chuong-nm/KiCad_LIB_project/3dmodels/degson-dg103-series-5-0mm-terminal-block-pack-1/STEP/DG103-5.0-xxP (pitch 5.0mm)/DG103.JPG

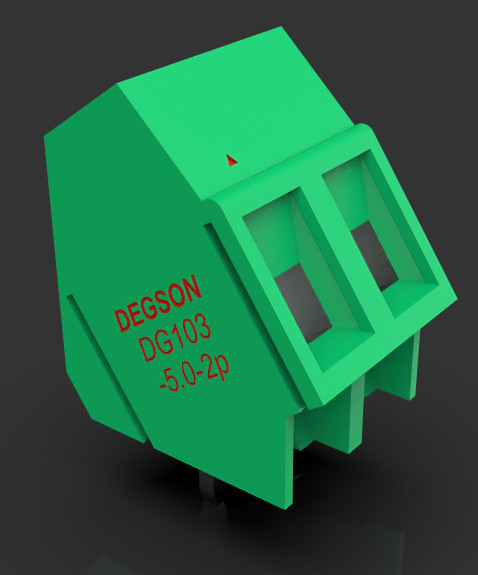
3dmodels/degson-dg103-series-5-0mm-terminal-block-pack-1/STEP/DG103-5.0-xxP (pitch 5.0mm)/DG103.JPG
