chuong-nm/KiCad_LIB_project/3dmodels/jst-gh-1-25mm-connector-set-1/JST Assortment - 1.25.PNG

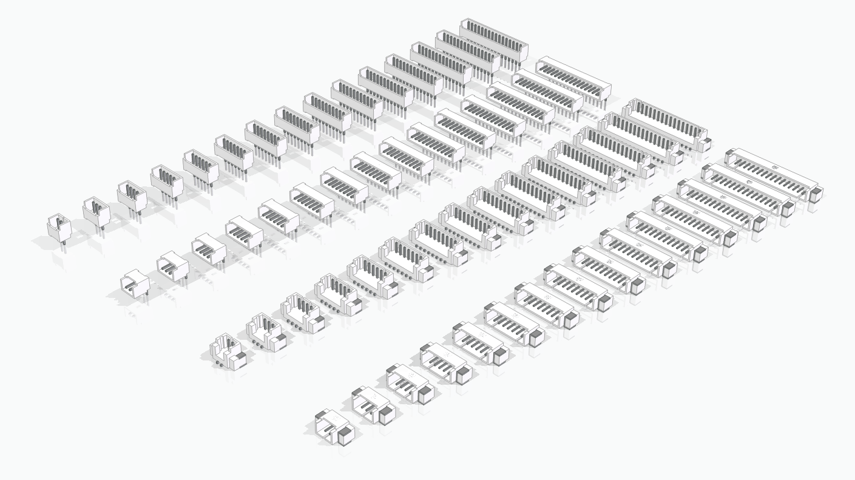
3dmodels/jst-gh-1-25mm-connector-set-1/JST Assortment - 1.25.PNG
