chuong-nm/KiCad_LIB_project/3dmodels/terminal-block-7-62mm-assortment/Terminal Block - 7.62mm - Assortment.PNG

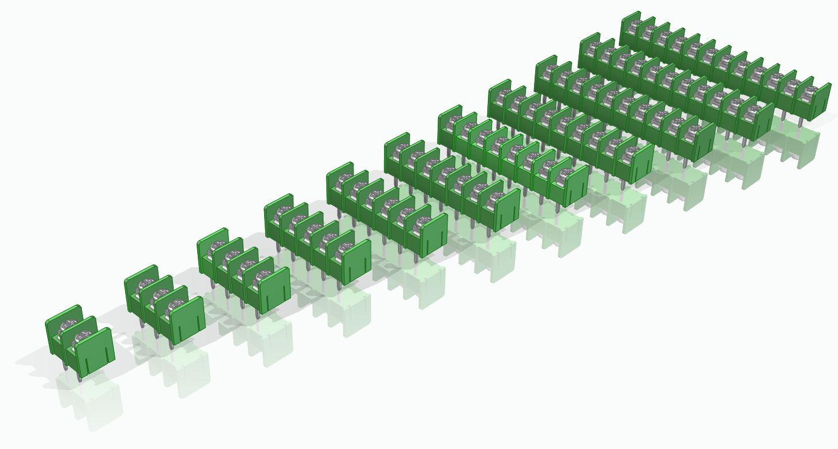
3dmodels/terminal-block-7-62mm-assortment/Terminal Block - 7.62mm - Assortment.PNG
