chuong-nm/KiCad_LIB_project/3dmodels/Converter_DCDC/OKI-78SR_Horizontal.FCStd

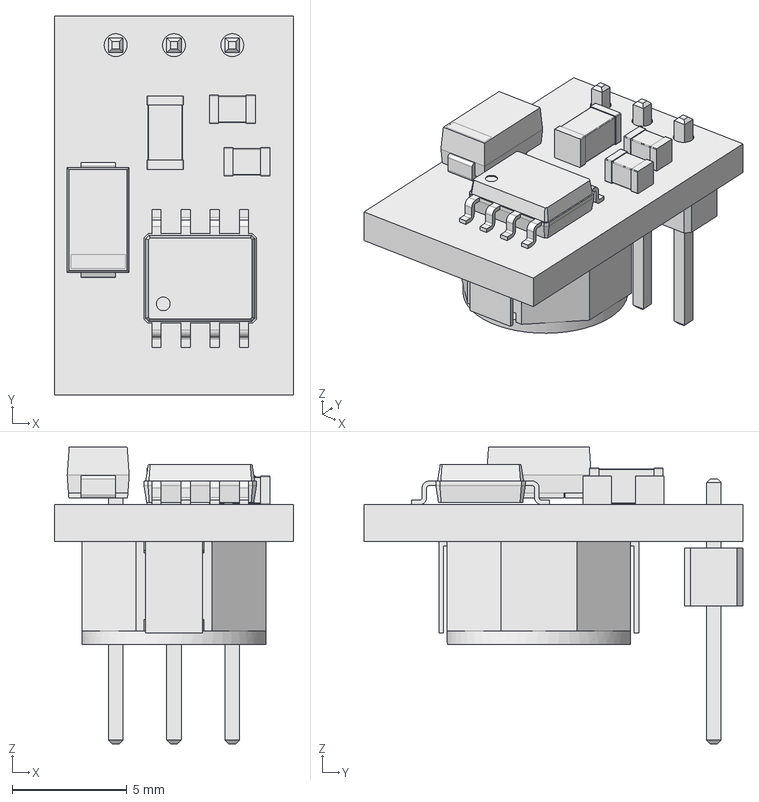
[picture p6: CAD file, 2022-12-01]
3dmodels/Converter_DCDC/OKI-78SR_Horizontal.FCStd
10.4 x 16.5 x 12.9 mm
