chuong-nm/KiCad_LIB_project/3dmodels/jst-gh-1-25mm-connector-set-1/JST - GH - SMD - Right - 1.25mm/JST - GH - SMD (R) - 5Pin - 1.25mm.stp

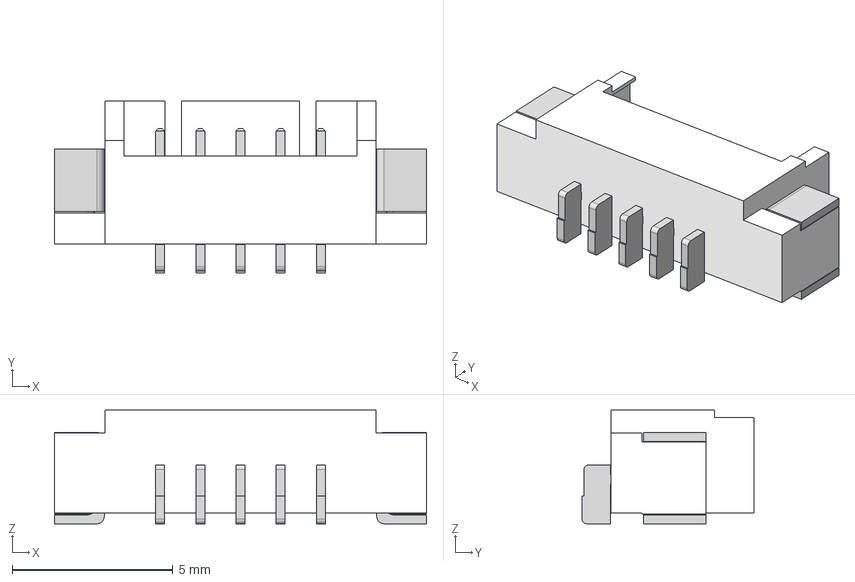
[picture p8: CAD file, 2022-12-01]
3dmodels/jst-gh-1-25mm-connector-set-1/JST - GH - SMD - Right - 1.25mm/JST - GH - SMD (R) - 5Pin - 1.25mm.stp
11.6 x 5.35 x 3.53 mm
