chuong-nm/KiCad_LIB_project/3dmodels/jst-gh-1-25mm-connector-set-1/JST - GH - Thru - Right - 1.25mm/JST - GH - Thru (R) - 14Pin - 1.25mm.stp

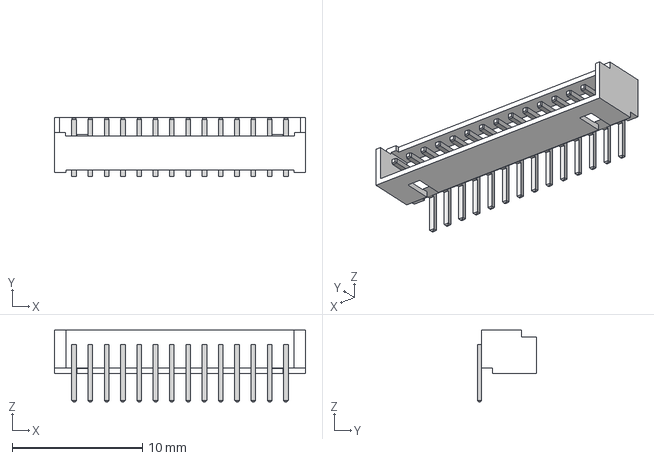
[picture p10: CAD file, 2022-12-01]
3dmodels/jst-gh-1-25mm-connector-set-1/JST - GH - Thru - Right - 1.25mm/JST - GH - Thru (R) - 14Pin - 1.25mm.stp
19.2 x 4.50 x 5.49 mm
