chuong-nm/KiCad_LIB_project/3dmodels/jst-gh-1-25mm-connector-set-1/JST - GH - Thru - Vertical - 1.25mm/JST - GH - Thru (V) - 14Pin - 1.25mm.stp

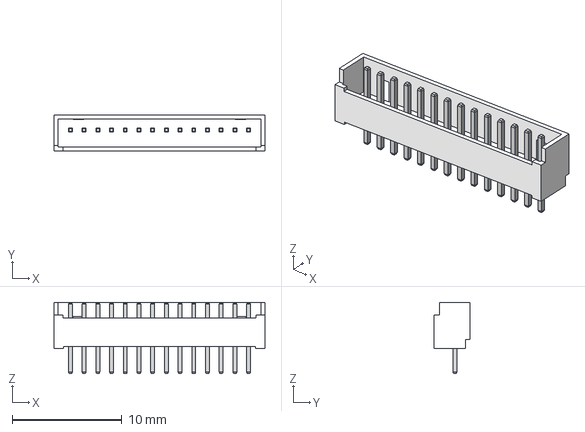
[picture p11: CAD file, 2022-12-01]
3dmodels/jst-gh-1-25mm-connector-set-1/JST - GH - Thru - Vertical - 1.25mm/JST - GH - Thru (V) - 14Pin - 1.25mm.stp
19.2 x 3.33 x 6.48 mm
