chuong-nm/KiCad_LIB_project/3dmodels/jst-sh-smd-connectors-1/SHR-xxV-S/SHR-14V-S.STEP

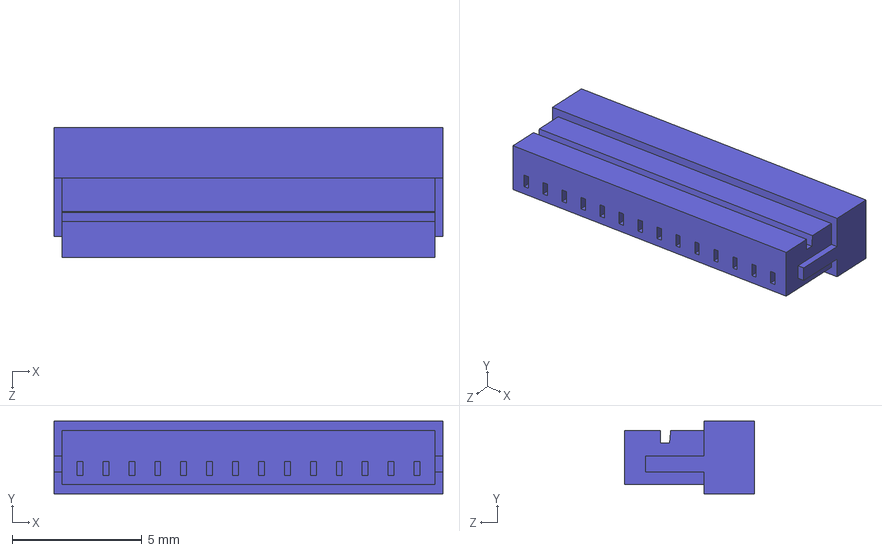
[picture p14: CAD file, 2022-12-01]
3dmodels/jst-sh-smd-connectors-1/SHR-xxV-S/SHR-14V-S.STEP
15.0 x 2.80 x 5.00 mm
