chuong-nm/KiCad_LIB_project/3dmodels/jst-sh-smd-connectors-1/SSH-003T-P0.2-H/SSH-003T-P0.2-H.STEP

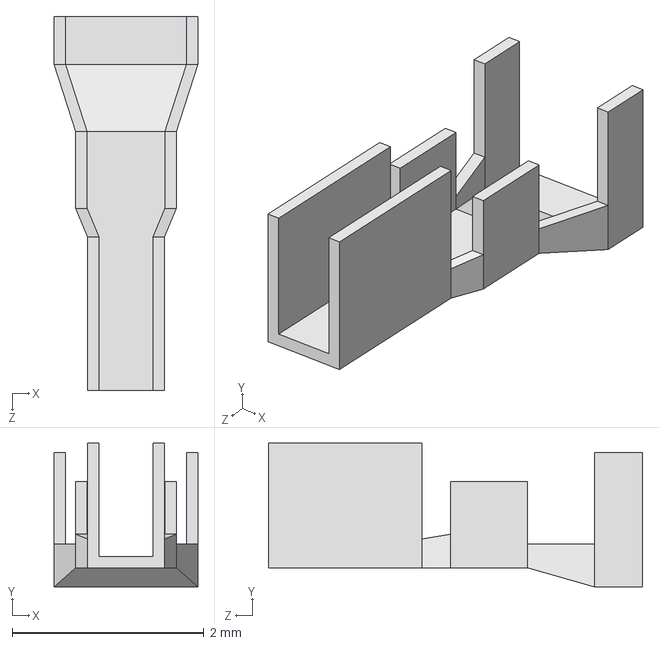
[picture p16: CAD file, 2022-12-01]
3dmodels/jst-sh-smd-connectors-1/SSH-003T-P0.2-H/SSH-003T-P0.2-H.STEP
1.50 x 1.50 x 3.90 mm
