chuong-nm/KiCad_LIB_project/3dmodels/Potentiometer_SMD.sdshapes/Potentiometer_Bourns_3314J_Vertical.FCStd

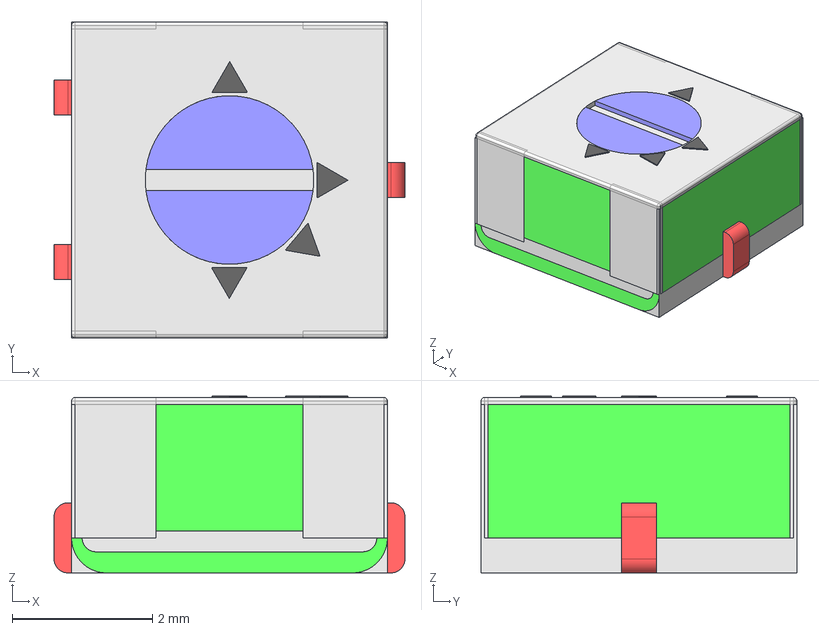
[picture p17: CAD file, 2022-12-01]
3dmodels/Potentiometer_SMD.sdshapes/Potentiometer_Bourns_3314J_Vertical.FCStd
5.00 x 4.50 x 2.52 mm
