chuong-nm/KiCad_LIB_project/3dmodels/SIM7600E.step

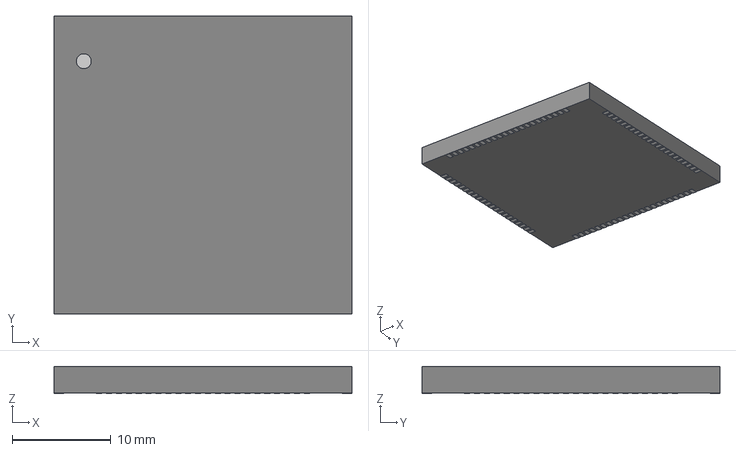
[picture p18: CAD file, 2023-04-05]
3dmodels/SIM7600E.step
30.1 x 30.1 x 2.75 mm
