chuong-nm/KiCad_LIB_project/3dmodels/terminal-block-7-62mm-assortment/Terminal Block - 7.62mm - 7 Pin.stp

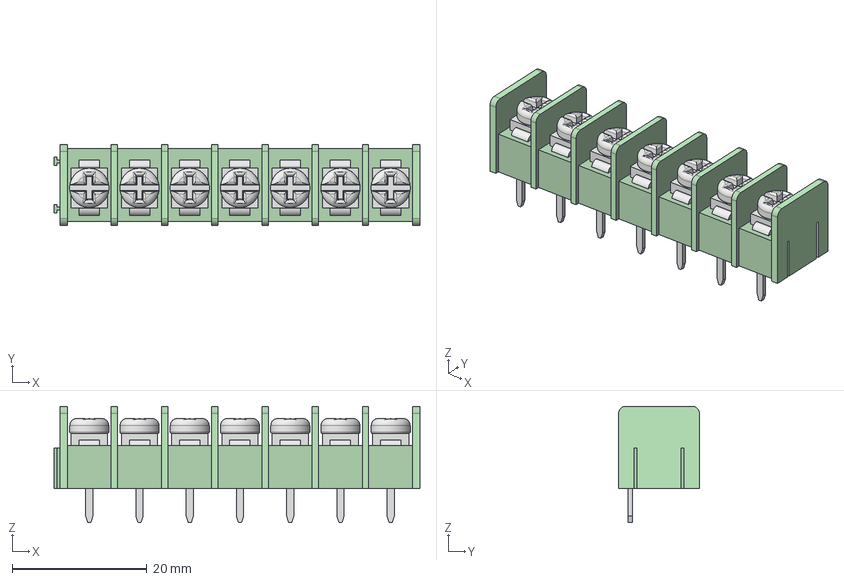
[picture p19: CAD file, 2022-12-01]
3dmodels/terminal-block-7-62mm-assortment/Terminal Block - 7.62mm - 7 Pin.stp
54.4 x 12.0 x 17.3 mm
