chuong-nm/KiCad_LIB_project/3dmodels/TerminalBlock_HB9500/HB9500_01x10_P9.50mm.step

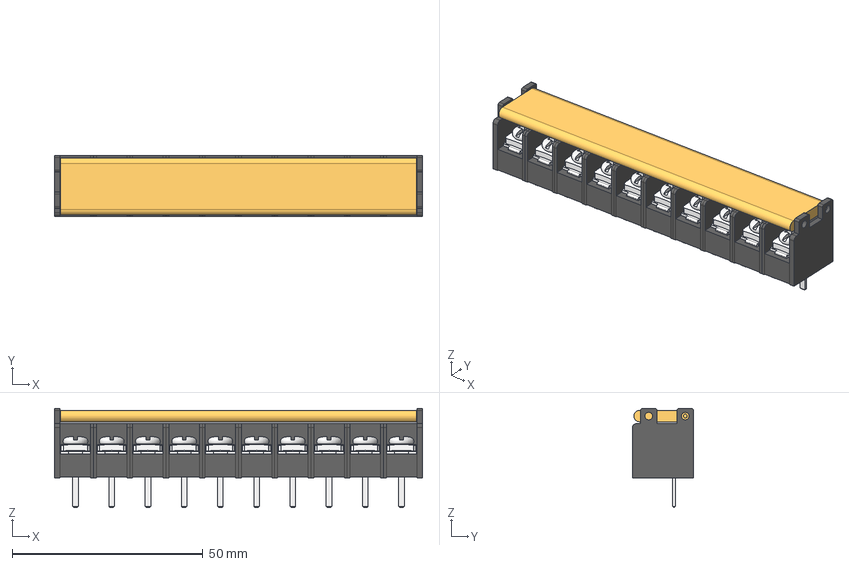
[picture p20: CAD file, 2022-12-01]
3dmodels/TerminalBlock_HB9500/HB9500_01x10_P9.50mm.step
96.5 x 16.0 x 26.0 mm
BodyLeft
BodyRight
Cover
LCS_Origin x 8
BodyCenter x 8
LCS_BodyCenter x 8
