chuong-nm/KiCad_LIB_project/3dmodels/Converter_DCDC/OKI-78SR_Vertical.FCStd

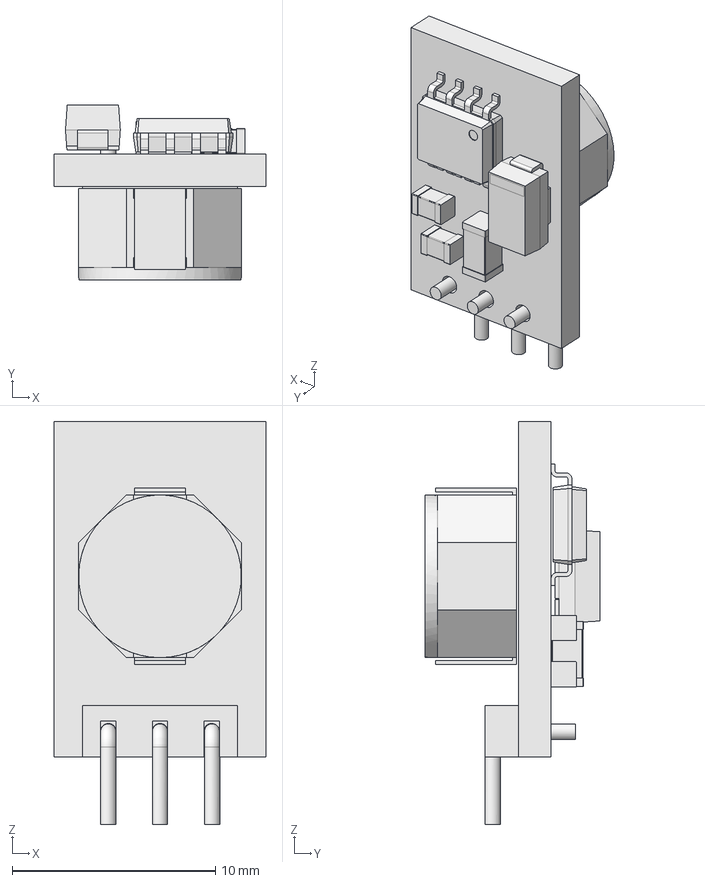
[picture p21: CAD file, 2022-12-01]
3dmodels/Converter_DCDC/OKI-78SR_Vertical.FCStd
10.4 x 8.60 x 19.8 mm
