chuong-nm/KiCad_LIB_project/3dmodels/LY68L6400SLIT.stp

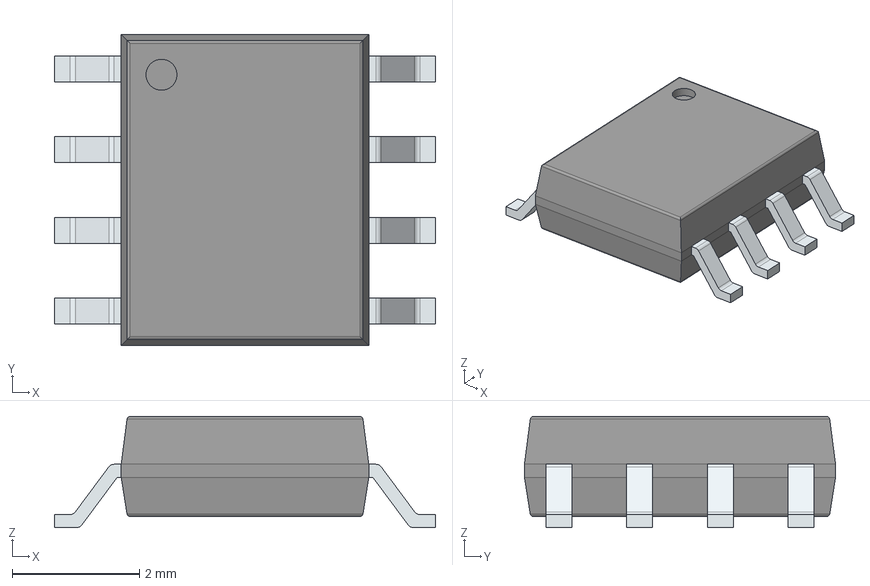
[picture p31: CAD file, 2022-12-01]
3dmodels/LY68L6400SLIT.stp
6.00 x 4.90 x 1.75 mm
PinsArrayLR
