chuong-nm/KiCad_LIB_project/3dmodels/terminal-block-7-62mm-assortment/Terminal Block - 7.62mm - 6 Pin.stp

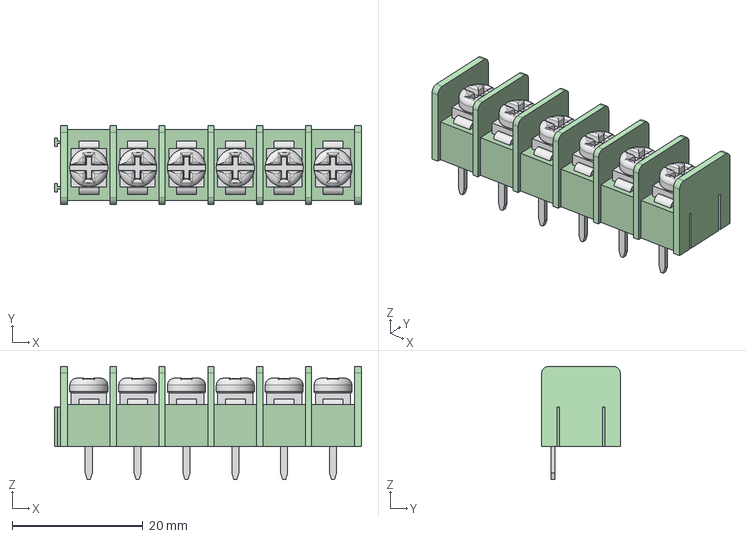
[picture p32: CAD file, 2022-12-01]
3dmodels/terminal-block-7-62mm-assortment/Terminal Block - 7.62mm - 6 Pin.stp
46.9 x 12.0 x 17.3 mm
