chuong-nm/KiCad_LIB_project/3dmodels/jst-sh-smd-connectors-1/SHR-xxV-S/SHR-09V-S.STEP

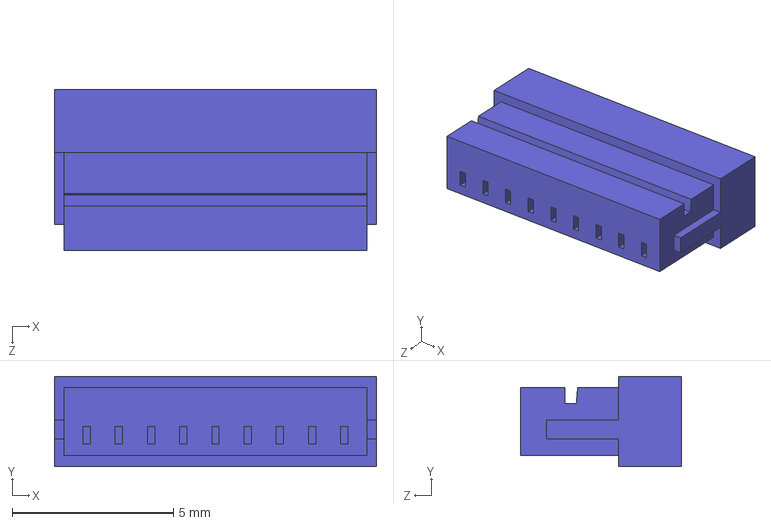
[picture p41: CAD file, 2022-12-01]
3dmodels/jst-sh-smd-connectors-1/SHR-xxV-S/SHR-09V-S.STEP
10.0 x 2.80 x 5.00 mm
