chuong-nm/KiCad_LIB_project/3dmodels/PCF8563TS_5,118.stp

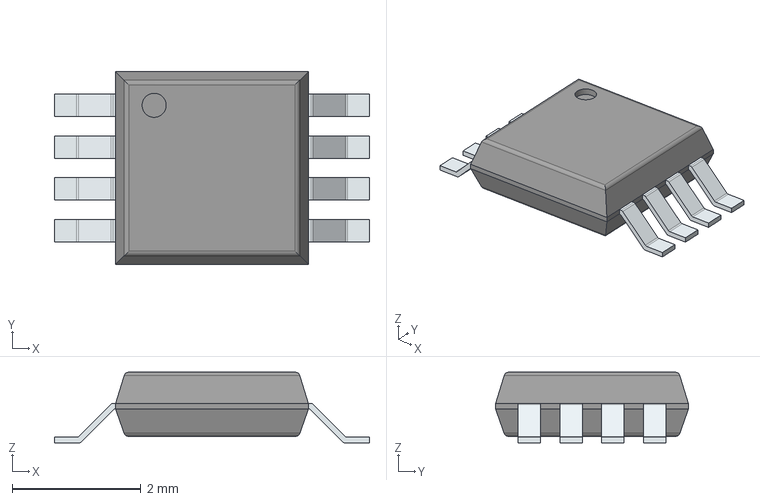
[picture p43: CAD file, 2022-12-01]
3dmodels/PCF8563TS_5,118.stp
4.90 x 3.00 x 1.10 mm
PinsArrayLR
