chuong-nm/KiCad_LIB_project/3dmodels/degson-dg103-series-5-0mm-terminal-block-pack-1/STEP/DG103-5.0-xxP (pitch 5.0mm)/DG103-5.0-02P-14-00AH.STEP

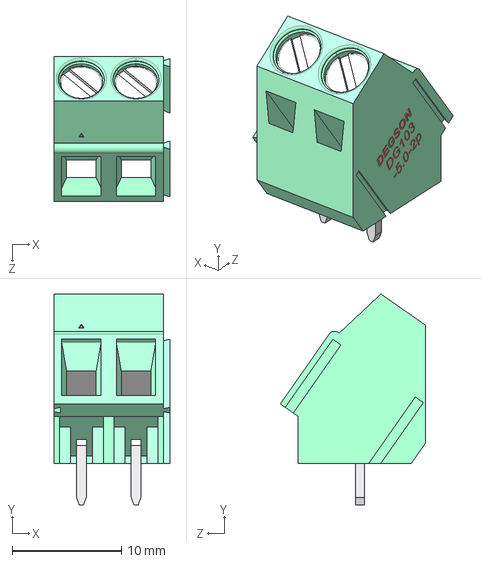
[picture p46: CAD file, 2022-12-01]
3dmodels/degson-dg103-series-5-0mm-terminal-block-pack-1/STEP/DG103-5.0-xxP (pitch 5.0mm)/DG103-5.0-02P-14-00AH.STEP
10.6 x 19.3 x 13.3 mm
