chuong-nm/KiCad_LIB_project/3dmodels/jst-gh-1-25mm-connector-set-1/JST - GH - Thru - Right - 1.25mm/JST - GH - Thru (R) - 6Pin - 1.25mm.stp

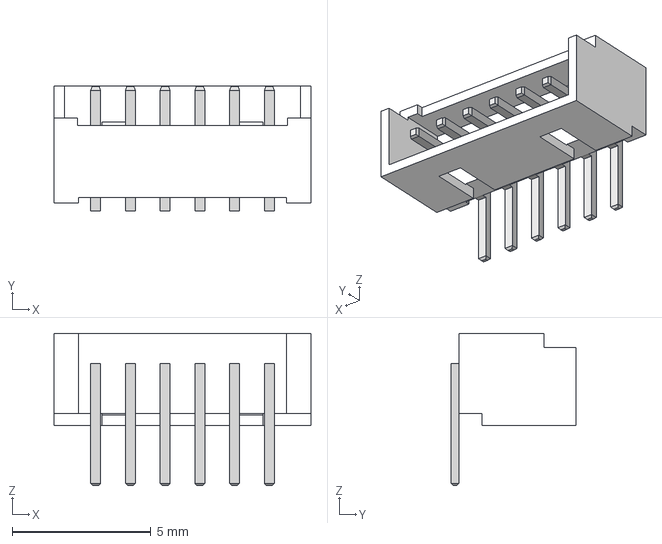
[picture p49: CAD file, 2022-12-01]
3dmodels/jst-gh-1-25mm-connector-set-1/JST - GH - Thru - Right - 1.25mm/JST - GH - Thru (R) - 6Pin - 1.25mm.stp
9.25 x 4.50 x 5.49 mm
