chuong-nm/KiCad_LIB_project/3dmodels/jst-sh-smd-connectors-1/BMxxB-SRSR-TB/BM10B-SRSS-TB.STEP

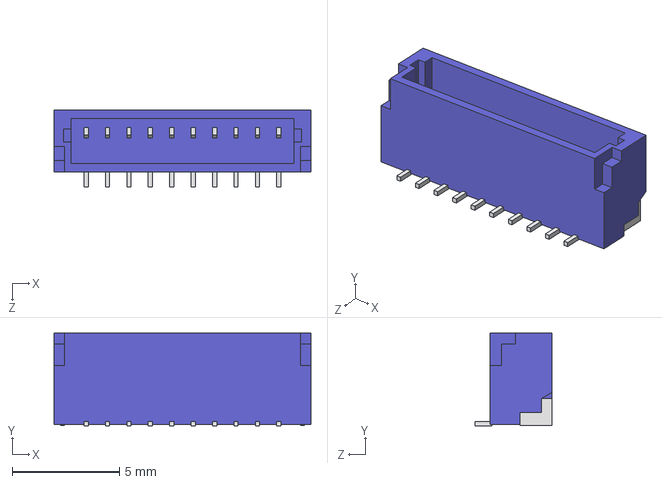
[picture p51: CAD file, 2022-12-01]
3dmodels/jst-sh-smd-connectors-1/BMxxB-SRSR-TB/BM10B-SRSS-TB.STEP
12.0 x 4.32 x 3.60 mm
