chuong-nm/KiCad_LIB_project/3dmodels/jst-sh-smd-connectors-1/SHR-xxV-S-B/SHR-04V-S-B.STEP

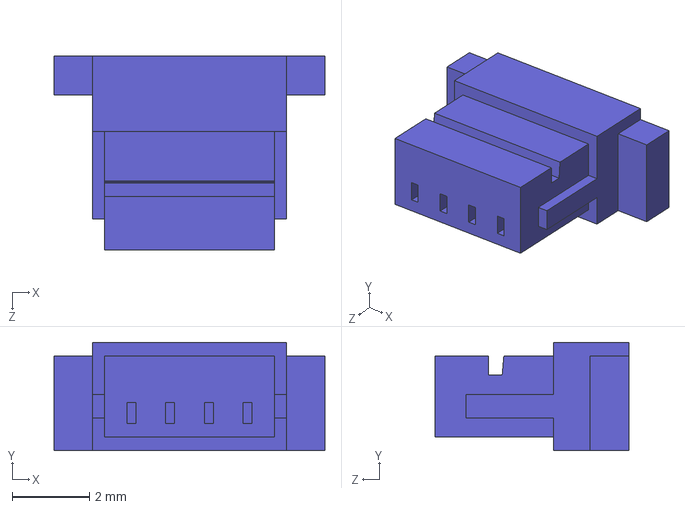
[picture p52: CAD file, 2022-12-01]
3dmodels/jst-sh-smd-connectors-1/SHR-xxV-S-B/SHR-04V-S-B.STEP
7.00 x 2.80 x 5.00 mm
