chuong-nm/KiCad_LIB_project/3dmodels/jst-sh-smd-connectors-1/SHR-xxV-S/SHR-12V-S.STEP

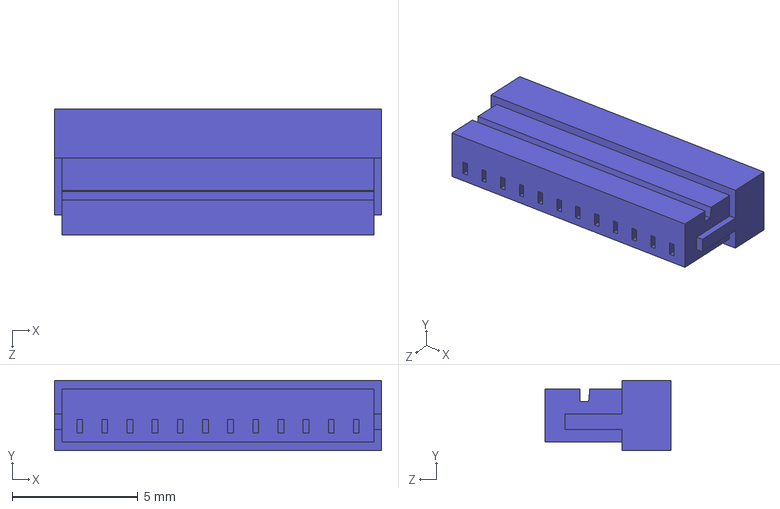
[picture p53: CAD file, 2022-12-01]
3dmodels/jst-sh-smd-connectors-1/SHR-xxV-S/SHR-12V-S.STEP
13.0 x 2.80 x 5.00 mm
