chuong-nm/KiCad_LIB_project/3dmodels/L0402C56NJRMST.stp

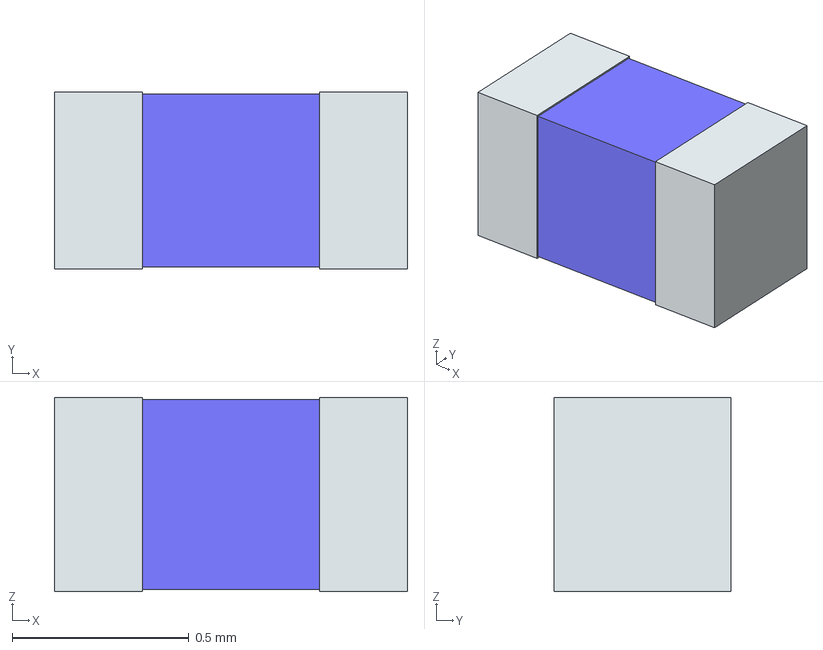
[picture p55: CAD file, 2022-12-01]
3dmodels/L0402C56NJRMST.stp
1.00 x 0.5 x 0.55 mm
term1
term2
