chuong-nm/KiCad_LIB_project/3dmodels/terminal-block-7-62mm-assortment/Terminal Block - 7.62mm - 12 Pin.stp

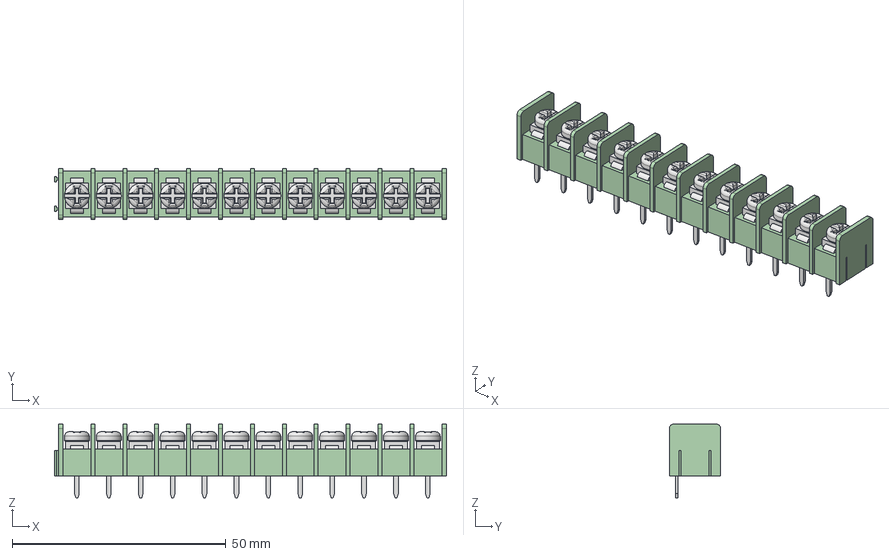
[picture p56: CAD file, 2022-12-01]
3dmodels/terminal-block-7-62mm-assortment/Terminal Block - 7.62mm - 12 Pin.stp
91.7 x 12.0 x 17.3 mm
