chuong-nm/KiCad_LIB_project/3dmodels/TerminalBlock_HB9500/HB9500_01x08_P9.50mm.step

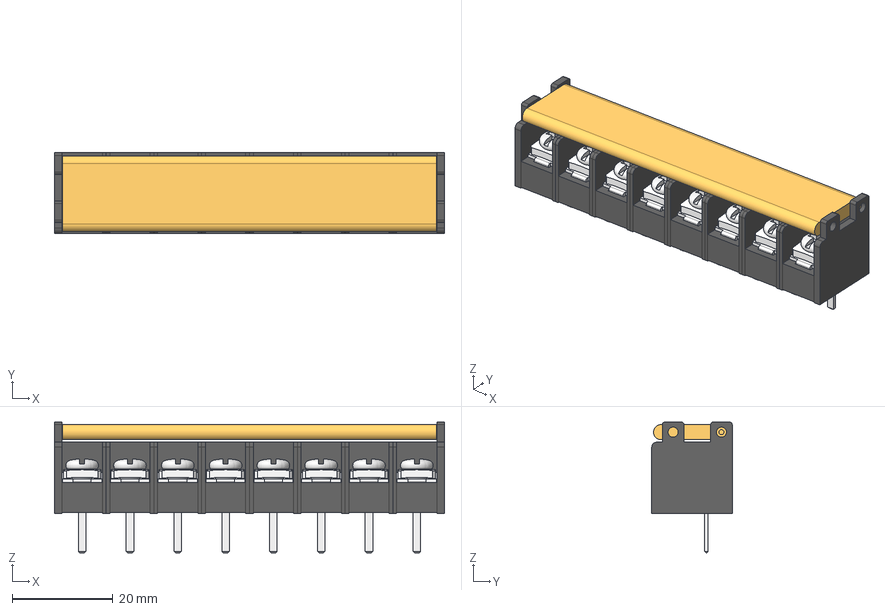
[picture p57: CAD file, 2022-12-01]
3dmodels/TerminalBlock_HB9500/HB9500_01x08_P9.50mm.step
77.5 x 16.0 x 26.0 mm
BodyLeft
BodyRight
Cover
LCS_Origin x 6
BodyCenter x 6
LCS_BodyCenter x 6
