chuong-nm/KiCad_LIB_project/3dmodels/21-0041B_8_MXM.step

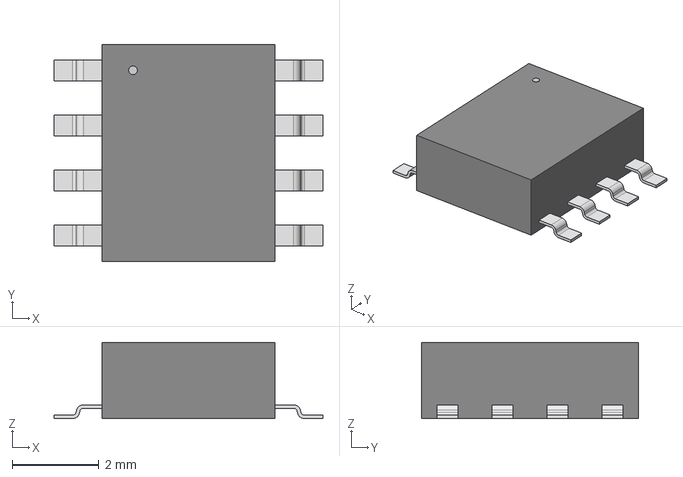
[picture p58: CAD file, 2022-12-01]
3dmodels/21-0041B_8_MXM.step
6.20 x 5.00 x 1.75 mm
