chuong-nm/KiCad_LIB_project/3dmodels/jst-gh-1-25mm-connector-set-1/JST - GH - SMD - Right - 1.25mm/JST - GH - SMD (R) - 9Pin - 1.25mm.stp

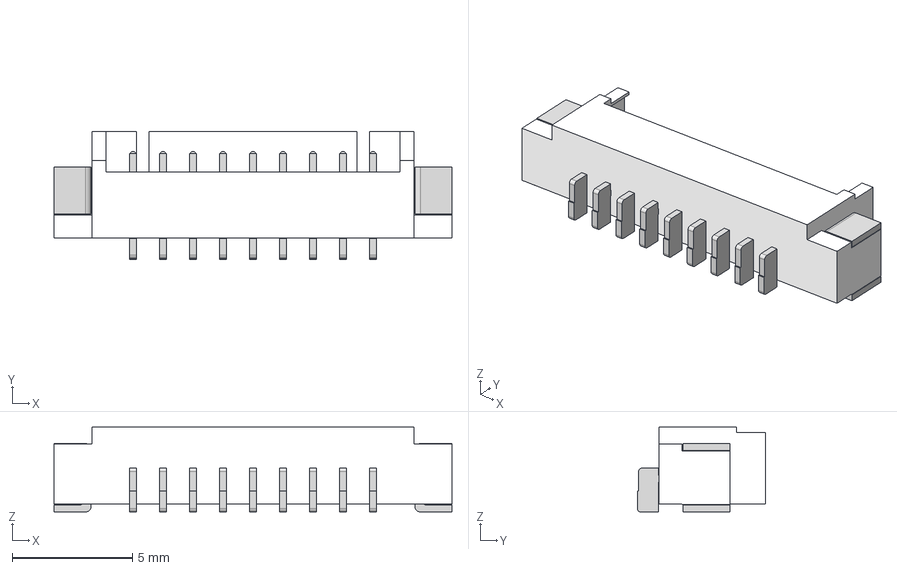
[picture p60: CAD file, 2022-12-01]
3dmodels/jst-gh-1-25mm-connector-set-1/JST - GH - SMD - Right - 1.25mm/JST - GH - SMD (R) - 9Pin - 1.25mm.stp
16.6 x 5.35 x 3.53 mm
