chuong-nm/KiCad_LIB_project/3dmodels/jst-gh-1-25mm-connector-set-1/JST - GH - SMD - Vertical - 1.25mm/JST - GH - SMD (V) - 16Pin - 1.25mm.stp

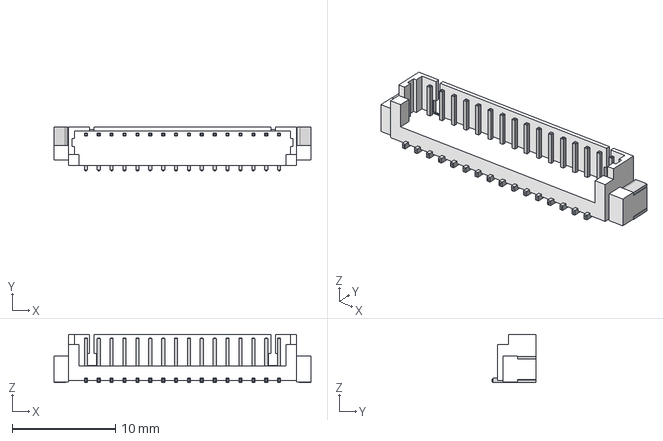
[picture p61: CAD file, 2022-12-01]
3dmodels/jst-gh-1-25mm-connector-set-1/JST - GH - SMD - Vertical - 1.25mm/JST - GH - SMD (V) - 16Pin - 1.25mm.stp
24.9 x 4.24 x 4.66 mm
