chuong-nm/KiCad_LIB_project/3dmodels/jst-sh-smd-connectors-1/SHR-xxV-S/SHR-06V-S.STEP

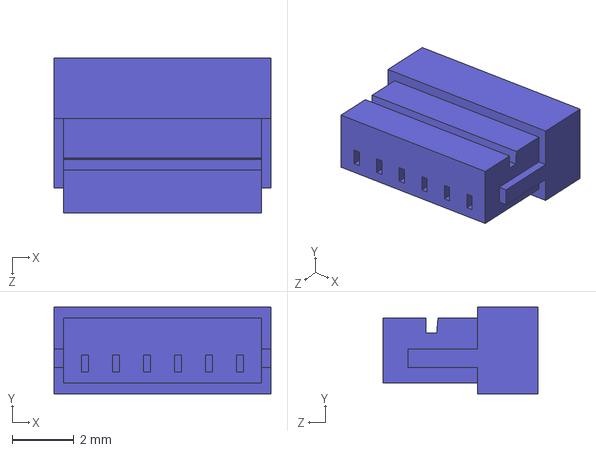
[picture p66: CAD file, 2022-12-01]
3dmodels/jst-sh-smd-connectors-1/SHR-xxV-S/SHR-06V-S.STEP
7.00 x 2.80 x 5.00 mm
