chuong-nm/KiCad_LIB_project/3dmodels/TerminalBlock_HB9500/HB9500_01x09_P9.50mm.step

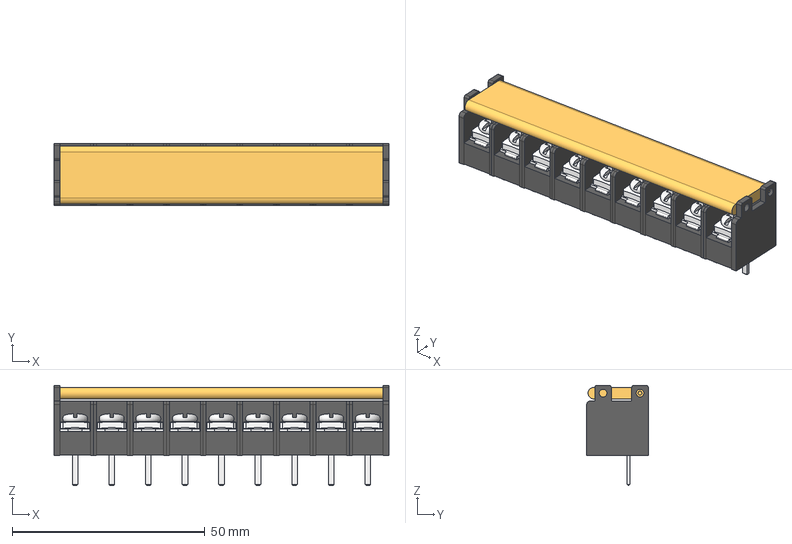
[picture p69: CAD file, 2022-12-01]
3dmodels/TerminalBlock_HB9500/HB9500_01x09_P9.50mm.step
87.0 x 16.0 x 26.0 mm
BodyLeft
BodyRight
Cover
LCS_Origin x 7
BodyCenter x 7
LCS_BodyCenter x 7
