chuong-nm/KiCad_LIB_project/3dmodels/GD25Q32CSIG.stp

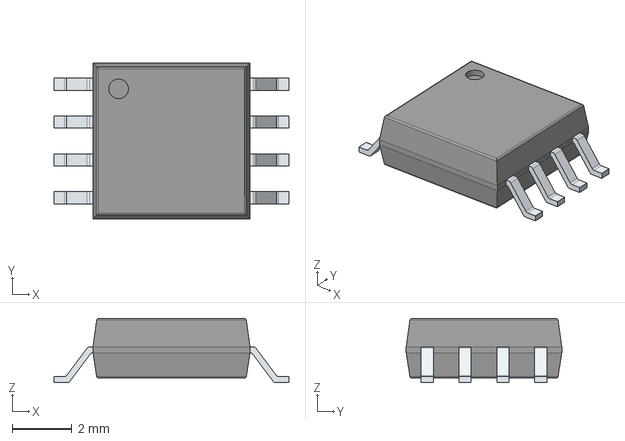
[picture p71: CAD file, 2022-12-01]
3dmodels/GD25Q32CSIG.stp
7.90 x 5.23 x 2.16 mm
PinsArrayLR
