chuong-nm/KiCad_LIB_project/3dmodels/2481AS.step

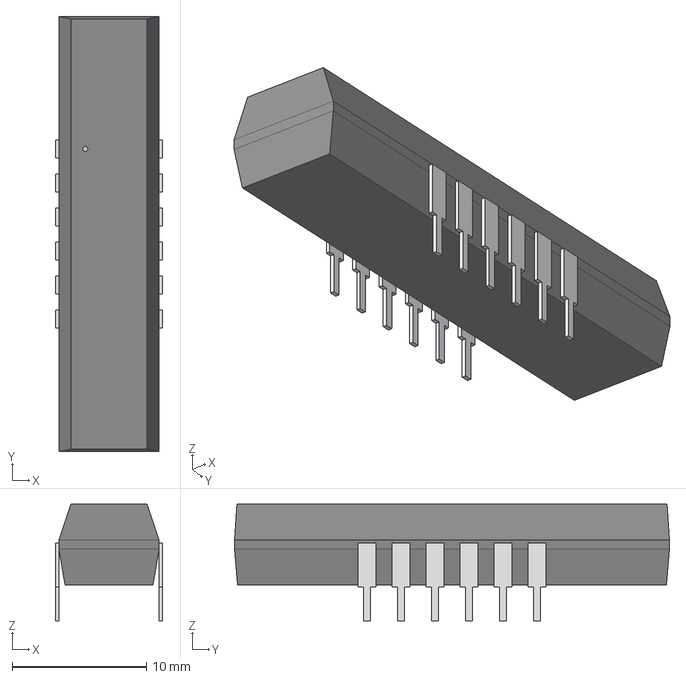
[picture p82: CAD file, 2022-12-01]
3dmodels/2481AS.step
7.99 x 32.5 x 8.71 mm
