chuong-nm/KiCad_LIB_project/3dmodels/TerminalBlock_HB9500/HB9500_01x02_P9.50mm.step

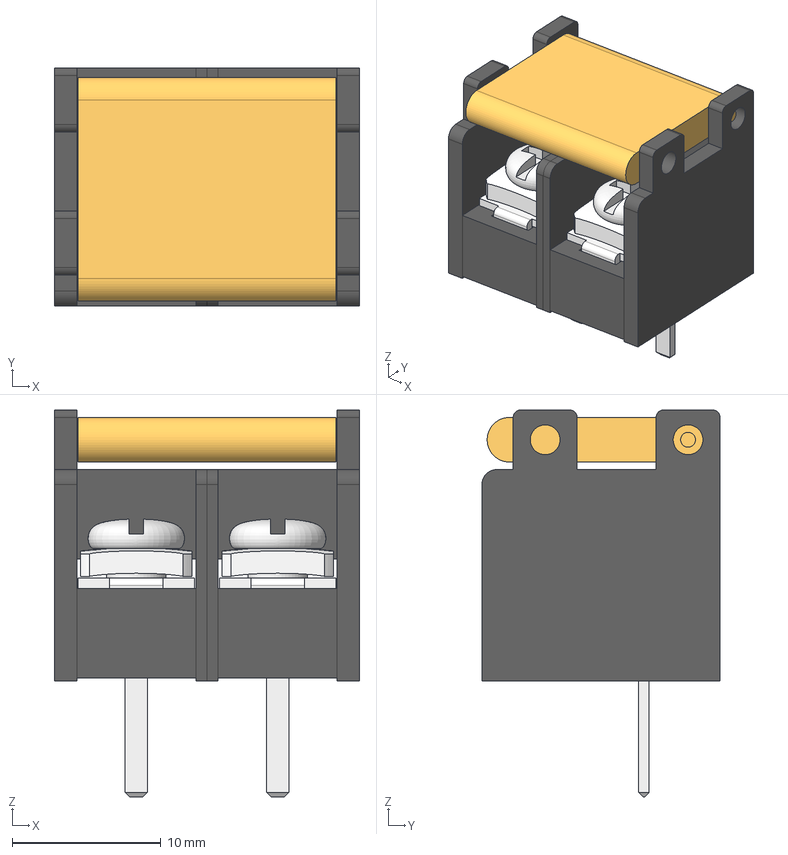
[picture p104: CAD file, 2022-12-01]
3dmodels/TerminalBlock_HB9500/HB9500_01x02_P9.50mm.step
20.5 x 16.0 x 26.0 mm
LCS_Origin
BodyLeft
LCS_BodyLeft
CoverAxisL
BodyRight
Cover
