chuong-nm/KiCad_LIB_project/3dmodels/CR1220_SMD.STEP

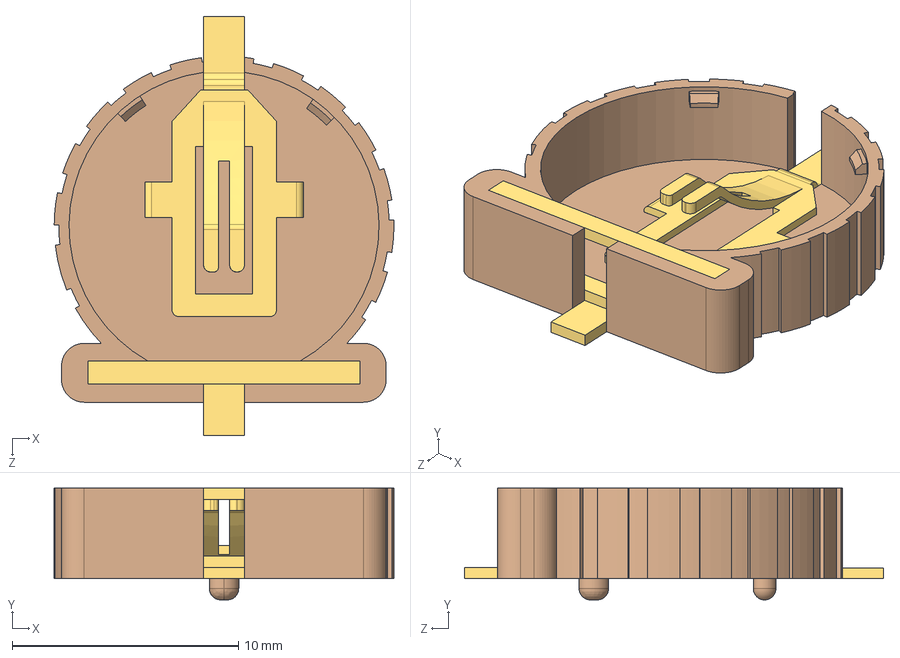
[picture p105: CAD file, 2022-12-01]
3dmodels/CR1220_SMD.STEP
15.0 x 4.94 x 18.5 mm
alsrobot-CR1220_User Library-cr1220_CR1220
alsrobot-CR1220_User Library-cr1220_PRT0001 x 2
alsrobot-CR1220_User Library-cr1220_PRT0002
alsrobot-CR1220_User Library-cr1220_PRT0003
alsrobot-CR1220_User Library-cr1220_PRT0004
