chuong-nm/KiCad_LIB_project/3dmodels/jst-sh-smd-connectors-1/SHR-xxV-S-B/SHR-11V-S-B.STEP

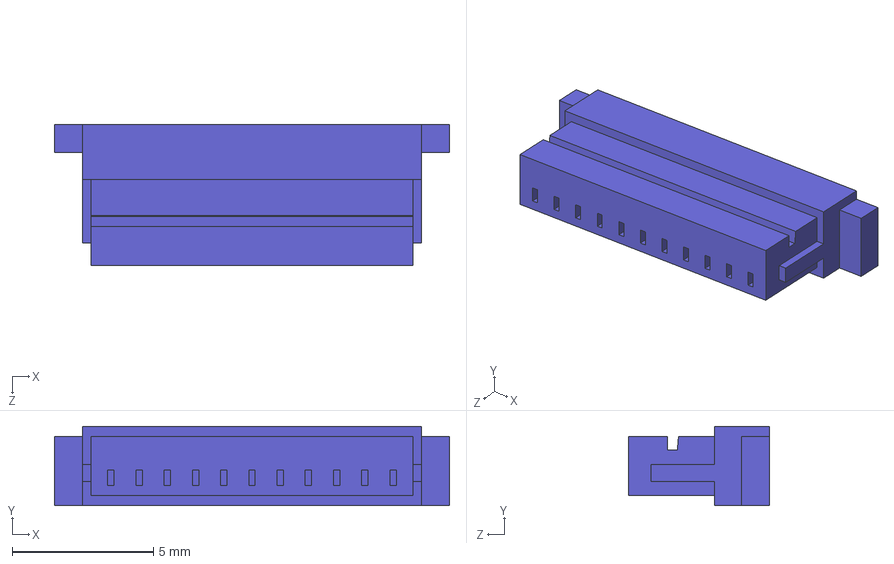
[picture p111: CAD file, 2022-12-01]
3dmodels/jst-sh-smd-connectors-1/SHR-xxV-S-B/SHR-11V-S-B.STEP
14.0 x 2.80 x 5.00 mm
