chuong-nm/KiCad_LIB_project/3dmodels/jst-sh-smd-connectors-1/SMxxB-SRSS-TB/SM05B-SRSS-TB.STEP

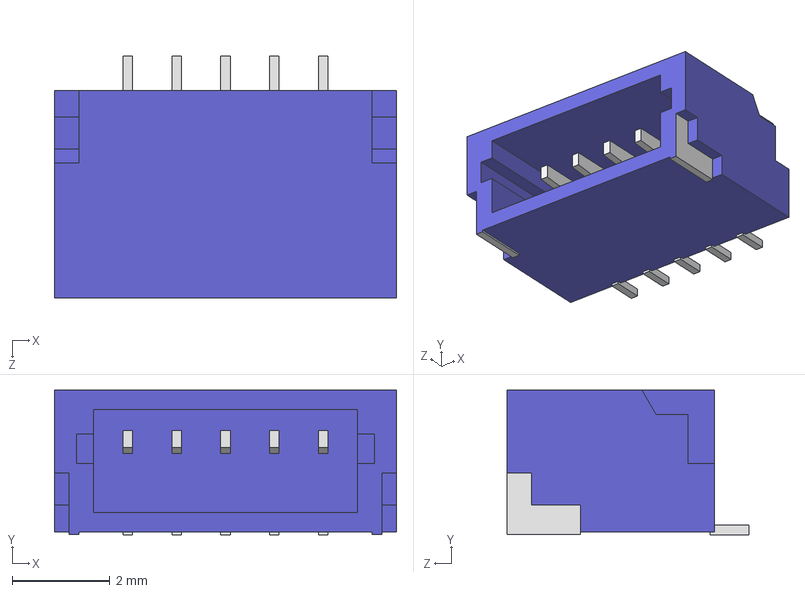
[picture p113: CAD file, 2022-12-01]
3dmodels/jst-sh-smd-connectors-1/SMxxB-SRSS-TB/SM05B-SRSS-TB.STEP
7.00 x 2.96 x 4.95 mm
