chuong-nm/KiCad_LIB_project/3dmodels/TerminalBlock_HB9500/HB9500_x10.FCStd

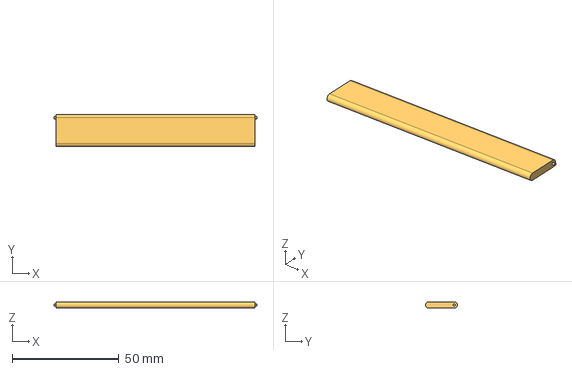
[picture p115: CAD file, 2022-12-01]
3dmodels/TerminalBlock_HB9500/HB9500_x10.FCStd
95.3 x 15.0 x 3.00 mm
