chuong-nm/KiCad_LIB_project/3dmodels/jst-sh-smd-connectors-1/BMxxB-SRSR-TB/BM15B-SRSS-TB.STEP

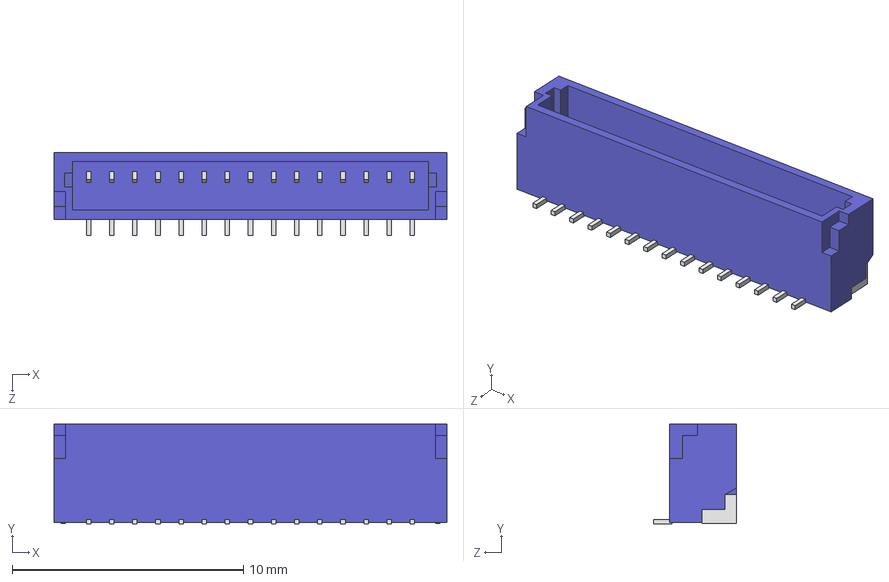
[picture p120: CAD file, 2022-12-01]
3dmodels/jst-sh-smd-connectors-1/BMxxB-SRSR-TB/BM15B-SRSS-TB.STEP
17.0 x 4.32 x 3.60 mm
