chuong-nm/KiCad_LIB_project/3dmodels/jst-sh-smd-connectors-1/SHR-xxV-S-B/SHR-03V-S-B.STEP

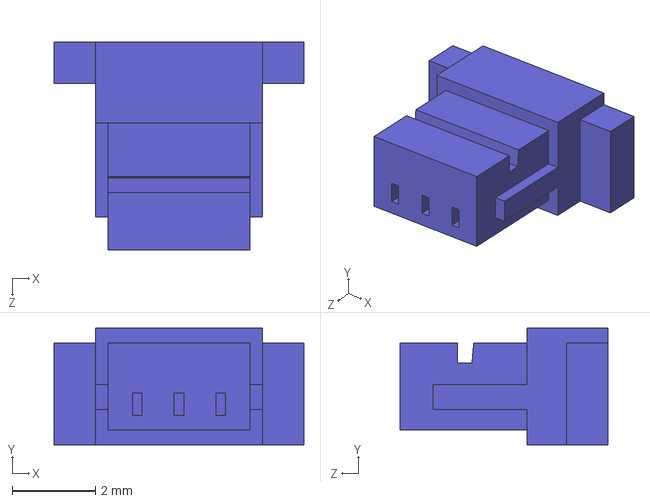
[picture p121: CAD file, 2022-12-01]
3dmodels/jst-sh-smd-connectors-1/SHR-xxV-S-B/SHR-03V-S-B.STEP
6.00 x 2.80 x 5.00 mm
