chuong-nm/KiCad_LIB_project/3dmodels/TDx01D485.step

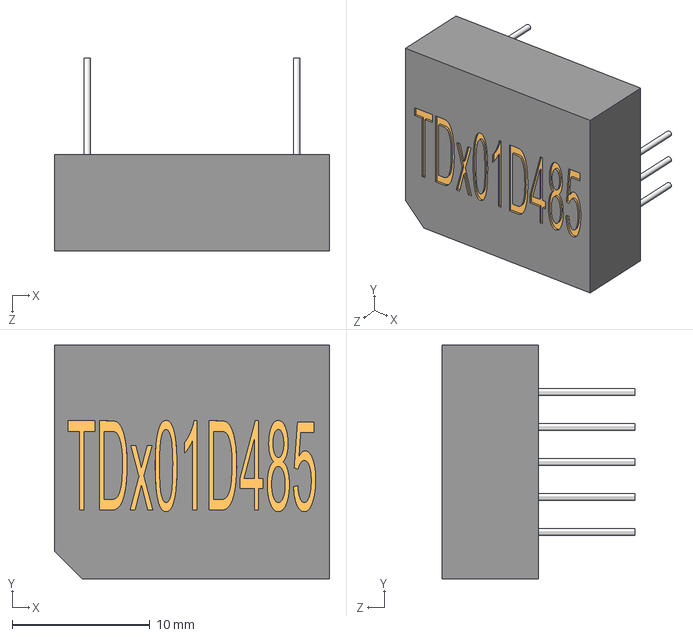
[picture p124: CAD file, 2022-12-01]
3dmodels/TDx01D485.step
20.0 x 17.0 x 14.0 mm
