chuong-nm/KiCad_LIB_project/3dmodels/TerminalBlock_HB9500/HB9500_01x03_P9.50mm.step

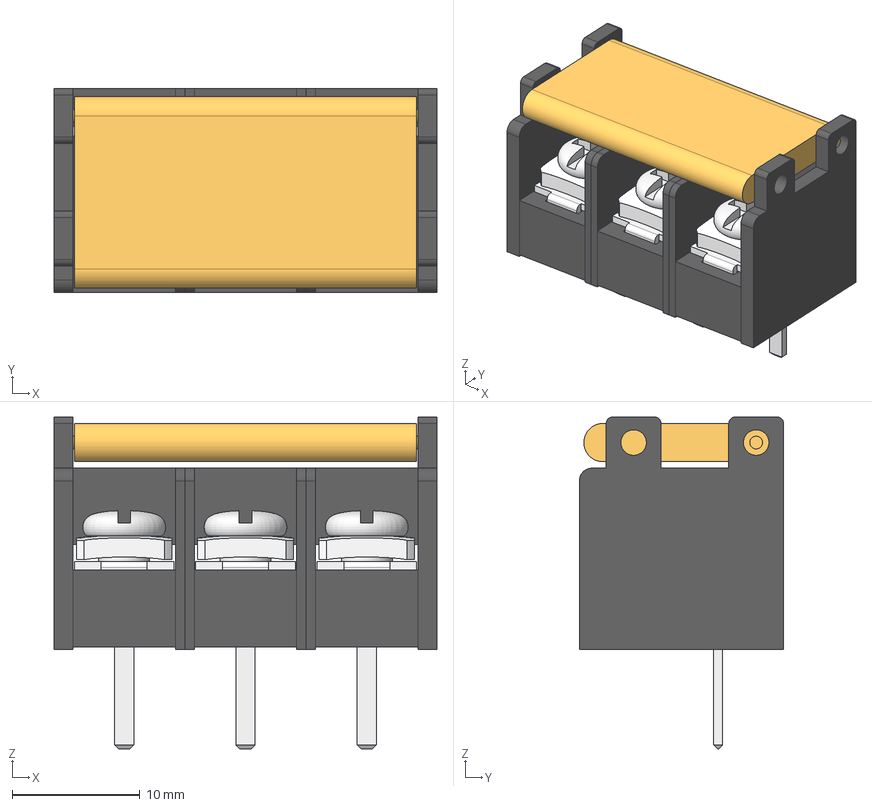
[picture p126: CAD file, 2022-12-01]
3dmodels/TerminalBlock_HB9500/HB9500_01x03_P9.50mm.step
30.0 x 16.0 x 26.0 mm
BodyLeft
BodyRight
Cover
BodyCenter
