chuong-nm/KiCad_LIB_project/3dmodels/TL064CD.STEP

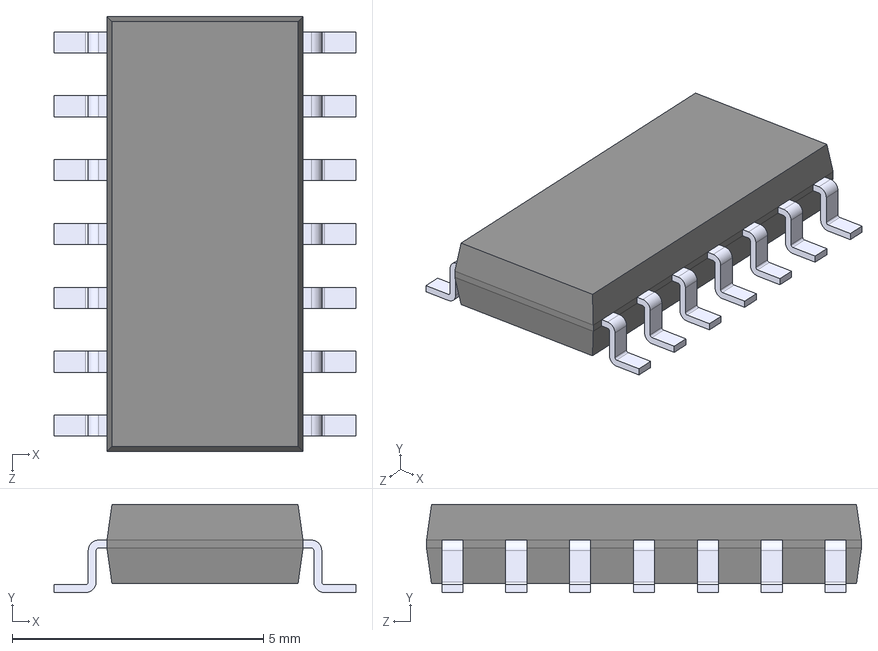
[picture p136: CAD file, 2022-12-01]
3dmodels/TL064CD.STEP
6.00 x 1.75 x 8.65 mm
