chuong-nm/KiCad_LIB_project/3dmodels/jst-sh-smd-connectors-1/BMxxB-SRSR-TB/BM06B-SRSS-TB.STEP

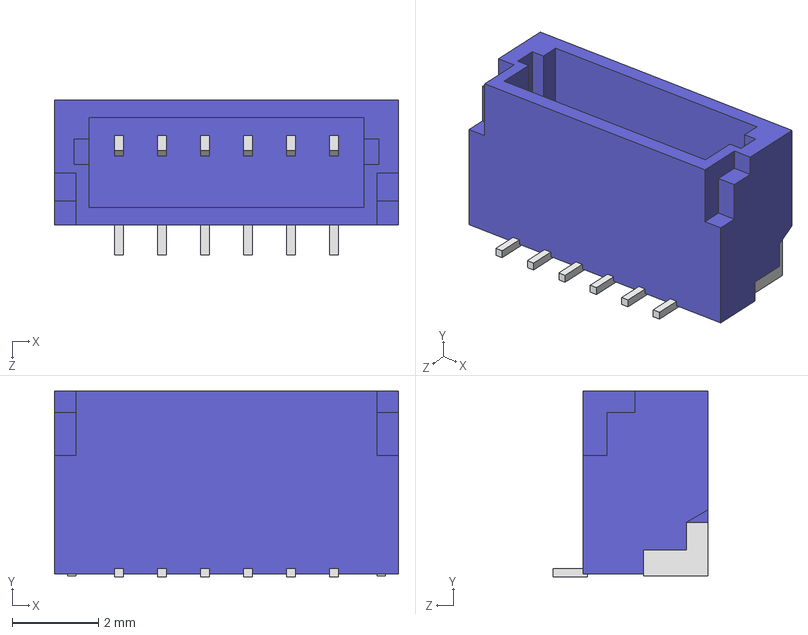
[picture p141: CAD file, 2022-12-01]
3dmodels/jst-sh-smd-connectors-1/BMxxB-SRSR-TB/BM06B-SRSS-TB.STEP
8.00 x 4.32 x 3.60 mm
