chuong-nm/KiCad_LIB_project/3dmodels/LoRa_Module_RA-02_AiThinker.step

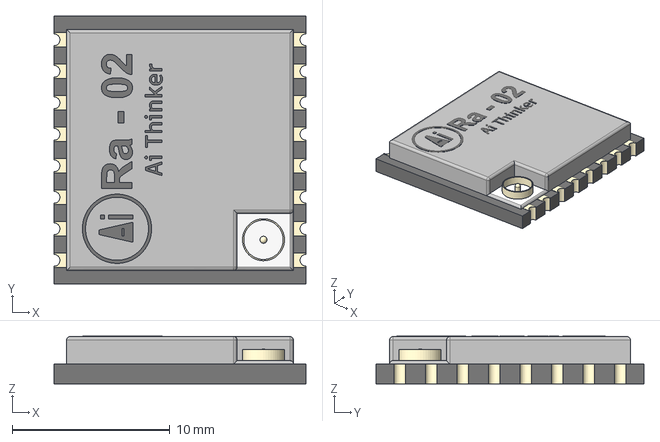
[picture p153: CAD file, 2022-12-01]
3dmodels/LoRa_Module_RA-02_AiThinker.step
16.0 x 17.0 x 3.03 mm
