chuong-nm/KiCad_LIB_project/(list of files, cad)

Other CAD files:
3dmodels/112J-TXAR-R_C_1-1.step
3dmodels/24LC256-I_SN.stp
3dmodels/3p2_TFT.step
3dmodels/AMS1117-3.3.stp
3dmodels/B5819W.stp
3dmodels/C0402C104K3RACTU.stp
3dmodels/C0402_CAPC1005x55N.step
3dmodels/C0603C159C5GALTU.stp
3dmodels/C0805C100J5GACTU.stp
3dmodels/C1206C100J5GACTU.stp
3dmodels/C1210C104KBRAC7800.stp
3dmodels/CAPC1608X87N.step
3dmodels/CAPC1608_55N.step
3dmodels/CC2530F256RHAR.stp
3dmodels/CR0402-FX-2000GLF.stp
3dmodels/CR0603-FX-1330ELF.stp
3dmodels/CR0805-FX-2553ELF.stp
3dmodels/CR1206-FX-1053ELF.stp
3dmodels/Conn_01x05_XHB-2.54mm_SMD.STEP
3dmodels/DS1307Z.step
3dmodels/ESP32-D0WD-V3.stp
3dmodels/Fuse Holder.STEP
3dmodels/GLCD12864.step
3dmodels/HLK-5M05.stp
3dmodels/HR911105A.step
3dmodels/HR915310A.stp
3dmodels/HRS1H-SDC5V.stp
3dmodels/KF103_P5.00_6P.stp
3dmodels/L0603100GGSTR.stp
3dmodels/L0805C1R0MPWST.stp
3dmodels/L1210R2R2MDWIT.stp
3dmodels/LED 2835.stp
3dmodels/LQM31PN4R7M00L.stp
3dmodels/L_7.3x7.3_H4.5.STEP
3dmodels/MMBT3904.stp
3dmodels/PushButton.step
3dmodels/Q13FC1350000200.step
3dmodels/R0603.step
3dmodels/RB521CS30L.step
3dmodels/Relay_G5NB.STEP
3dmodels/SHT3x.STEP
3dmodels/SI2301.stp
3dmodels/SLA-05VDC-SL-C.stp
3dmodels/SMAJ24CA.step
3dmodels/SMA_Delock_65848.step
3dmodels/SMD-3225_4P24MHZ12PF10PPM-40~+85b.stp
3dmodels/SMD3225_4P24MHZ12PF10PPM4085.STEP
3dmodels/SOIC-8_3.9x4.9mm_P1.27mm.step
3dmodels/SOIC-8_5.23x5.23mm_P1.27mm.step
3dmodels/SOIC127P600X175-14N.step
3dmodels/SOIC127P790X216-8N.step
3dmodels/SOIC14.stp
3dmodels/SOP-8_3.76x4.96mm_P1.27mm.STEP
3dmodels/SW_Push_4.5x4.5x3.8mm_SMD.STEP
3dmodels/TLP187_TPL,E.stp
3dmodels/UU98.stp
3dmodels/XHB-2_54-4P.step
3dmodels/XHB-2_54-5P.step
3dmodels/XHB-2_54-7P.stp
3dmodels/gasDischargeTubeA.STEP
3dmodels/hlk-pm01.step
3dmodels/jst-gh-1-25mm-connector-set-1/JST - GH - SMD - Right - 1.25mm/JST - GH - SMD (R) - 13Pin - 1.25mm.stp
3dmodels/jst-gh-1-25mm-connector-set-1/JST - GH - SMD - Vertical - 1.25mm/JST - GH - SMD (V) - 10Pin - 1.25mm.stp
3dmodels/jst-gh-1-25mm-connector-set-1/JST - GH - SMD - Vertical - 1.25mm/JST - GH - SMD (V) - 11Pin - 1.25mm.stp
3dmodels/jst-gh-1-25mm-connector-set-1/JST - GH - Thru - Right - 1.25mm/JST - GH - Thru (R) - 10Pin - 1.25mm.stp
3dmodels/jst-gh-1-25mm-connector-set-1/JST - GH - Thru - Right - 1.25mm/JST - GH - Thru (R) - 4Pin - 1.25mm.stp
3dmodels/jst-gh-1-25mm-connector-set-1/JST - GH - Thru - Vertical - 1.25mm/JST - GH - Thru (V) - 16Pin - 1.25mm.stp
3dmodels/jst-gh-1-25mm-connector-set-1/JST - GH - Thru - Vertical - 1.25mm/JST - GH - Thru (V) - 5Pin - 1.25mm.stp
3dmodels/jst-sh-smd-connectors-1/BMxxB-SRSR-TB/BM05B-SRSS-TB.STEP
3dmodels/jst-sh-smd-connectors-1/SHR-xxV-S-B/SHR-05V-S-B.STEP
3dmodels/jst-sh-smd-connectors-1/SHR-xxV-S-B/SHR-14V-S-B.STEP
3dmodels/jst-sh-smd-connectors-1/SHR-xxV-S/SHR-07V-S.STEP
3dmodels/jst-sh-smd-connectors-1/SMxxB-SRSS-TB/SM09B-SRSS-TB.STEP
3dmodels/jst-sh-smd-connectors-1/SMxxB-SRSS-TB/SM11B-SRSS-TB.STEP
