chuong-nm/KiCad_LIB_project/3dmodels/degson-dg103-series-5-0mm-terminal-block-pack-1/Datash/degson_dg103-5.0.pdf

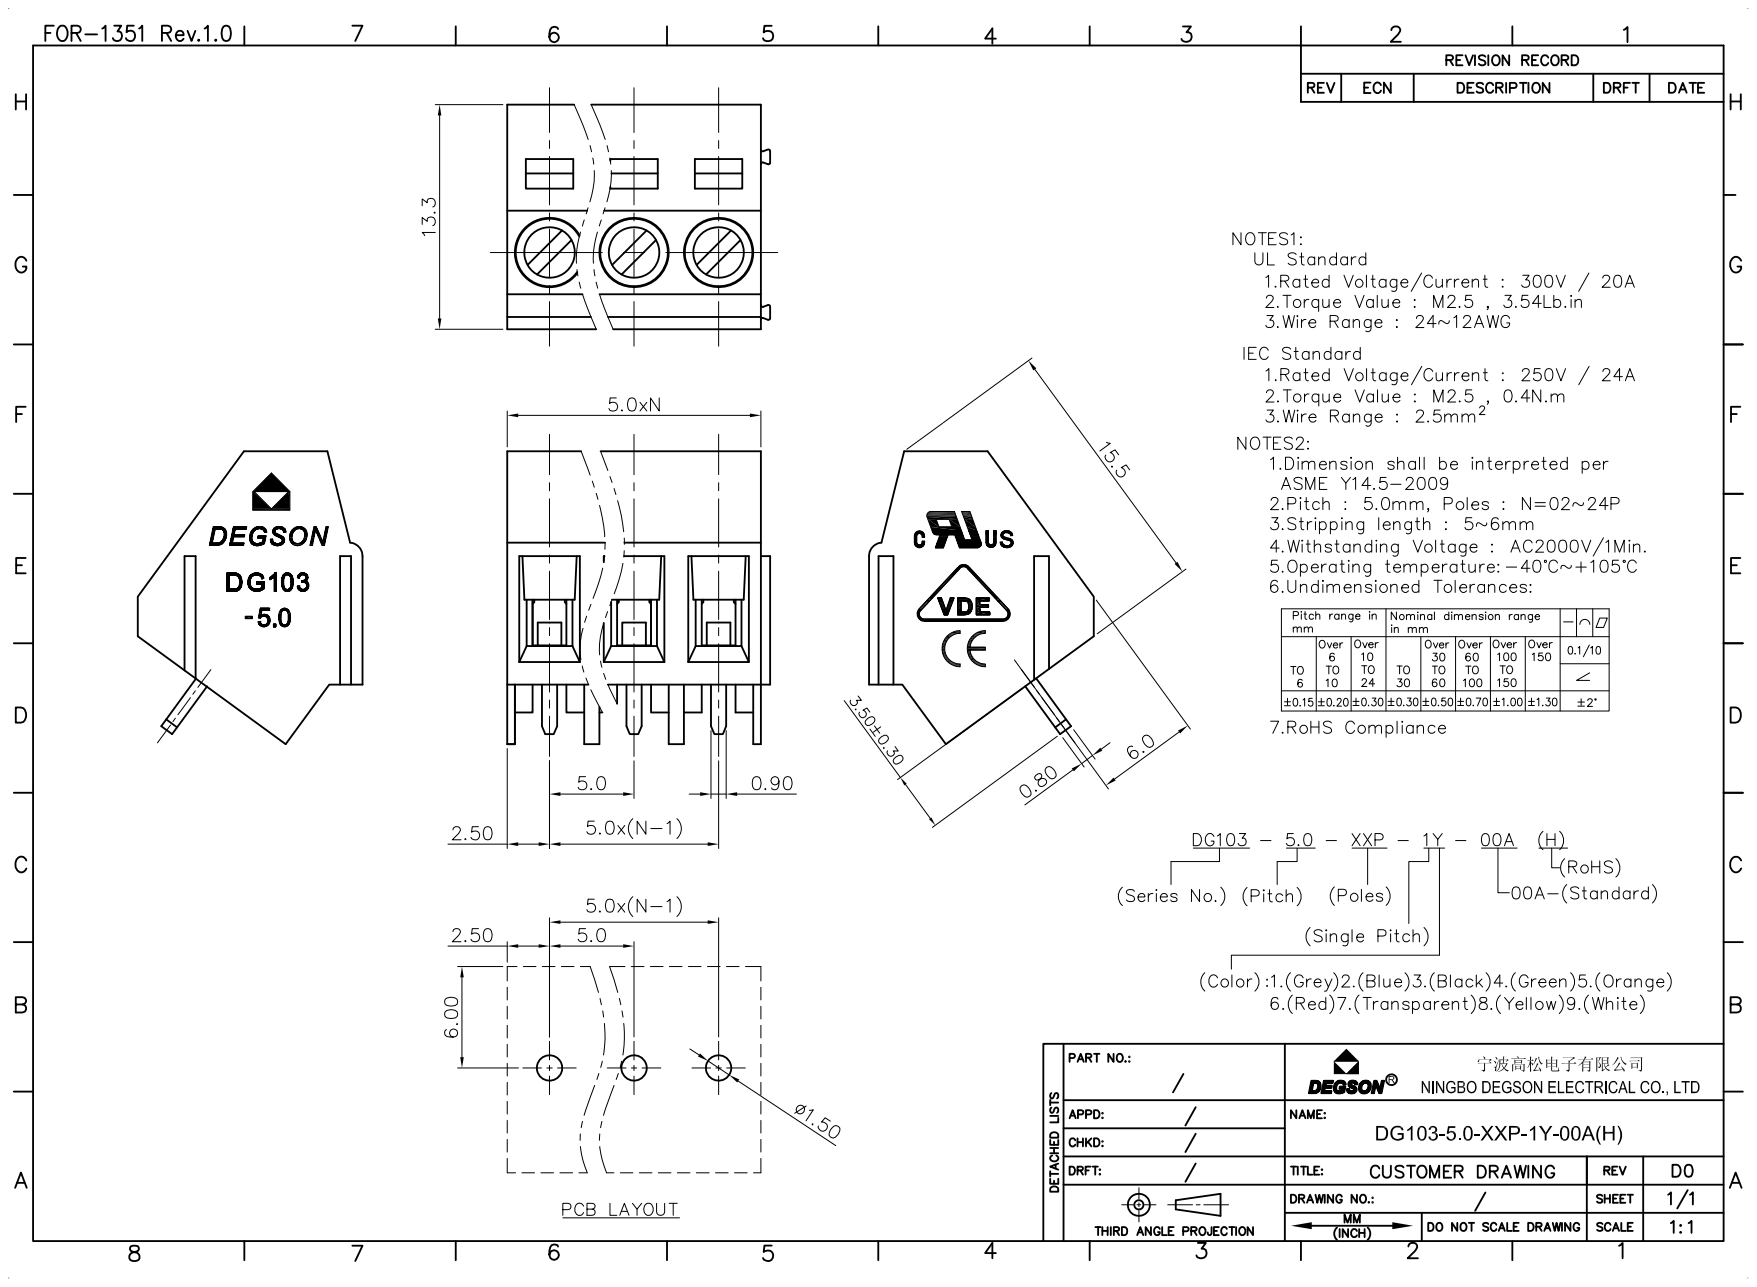
[picture p155: page 1]
