chuong-nm/KiCad_LIB_project/3dmodels/degson-dg103-series-5-0mm-terminal-block-pack-1/Datash/dg103.pdf

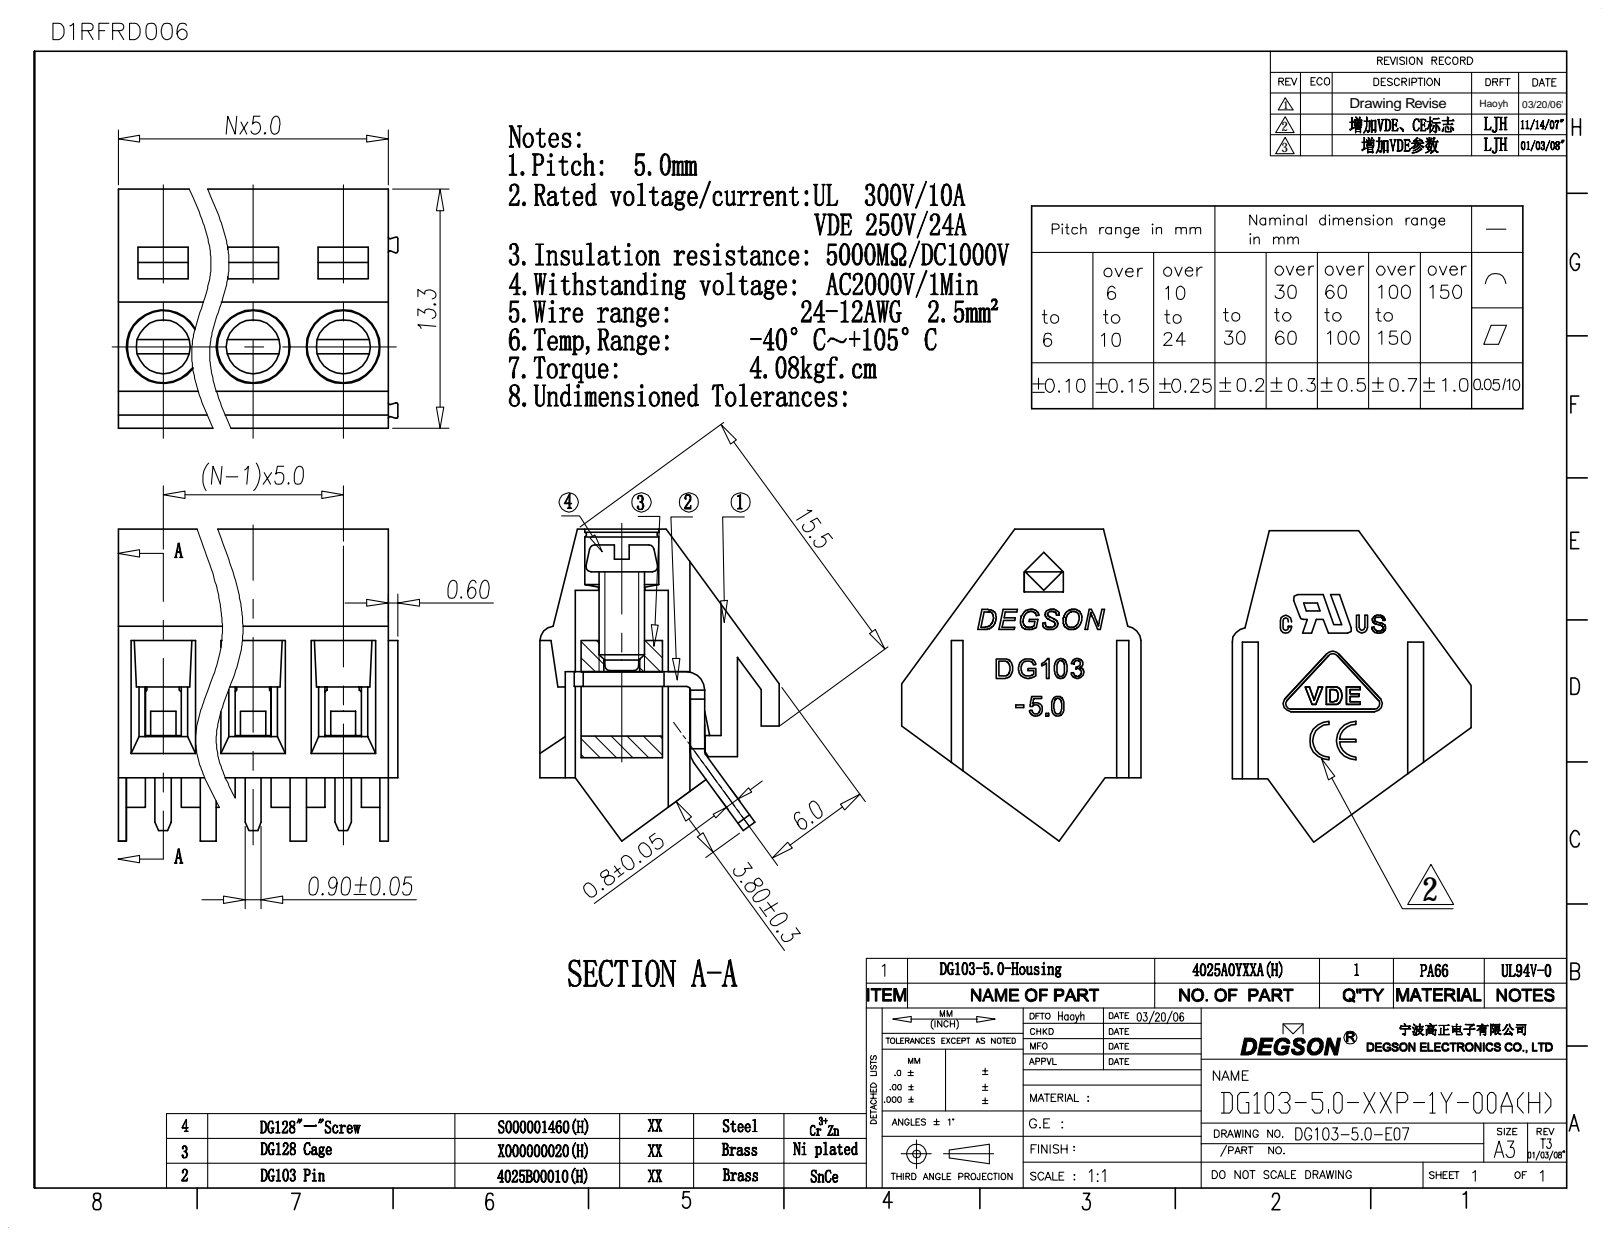
[picture p156: page 1]
Drawing Revise; Haoyh
